Shivasa042/Potentiostat-Wearable-Sensor-Berkeley-MEng-Capstone/Originallibraries/HELPStat-main 4/HELPStat/Hardware/PCBWayQuotedBOM_5Sets_2024-01-11.xls

PCBWay Bom Quotation, Product No.:T-1Y23W557788A
Item # | *Designator | *Qty | Manufacturer | *Mfg Part # | Description / Value | Vendor Part # | *Package/Footprint | Mounting Type | Category | *Unit Price(5 sets) | *Total | *Delivery Time | *Actual Purchase Mfg Part #
1 | MCU | 1 | Espressif Systems | ESP32-S3-WROOM-1-N8R8 | Bluetooth, WiFi 802.11b/g/n, Bluetooth v5.0 Transceiver Module 2.4GHz PCB Trace Surface Mount | Digi-Key『 』1965-ESP32-S3-WROOM-1-N8R8CT-ND | 41-SMD Module | SMD | ESP32-S3-WROOM-1-N8R8 | $6.205 | $31.025 | 7-10 Workdays
2 | LDO | 1 | Diodes Incorporated | AP2112K-3.3TRG1 | Linear Voltage Regulator IC Positive Fixed 1 Output 600mA SOT-25 | Digi-Key『 』AP2112K-3.3TRG1DITR-ND | SOT-25 | SMD | 3.3V Regulator | $0.173 | $0.865
3 | USB | 1 | Amphenol FCI | 10118192-0001LF | USB - micro B USB 2.0 Receptacle Connector 5 Position Surface Mount, Right Angle | Digi-Key『 』609-4613-1-ND | Flange, Horizontal | SMD | Micro USB | $0.447 | $2.235
4 | Q1 | 1 | Diodes Incorporated | DMG2307LQ-7 | P-Channel 30 V 2.5A (Ta) 760mW (Ta) Surface Mount SOT-23-3 | Digi-Key『 』31-DMG2307LQ-7TR-ND | SOT-23-3 | SMD | PFET | $0.161 | $0.805
5 | D1 | 1 | STMicroelectronics | BAT20JFILM | DIODE SCHOTTKY 23V 1A SOD323 | Digi-Key『 』497-3381-2-ND | SOD-323 | SMD | Schottky Diode | $0.157 | $0.785
6 | RST, BOOT | 2 | C&K Components | PTS830GM140 SMTR LFS | Tactile Switch SPST-NO Top Actuated Surface Mount | Digi-Key『 』CKN10587CT-ND | Gull Wing | SMD | Tiny Rectangular Button | $0.925 | $9.250 | 7-10 Workdays
7 | IC1 | 1 | Microchip Technology | MCP73812T-420I/OT | IC BATT CNTL LI-ION 1CEL SOT23-5 | Digi-Key『 』MCP73812T-420I/OTTR-ND | SOT-23-5 | SMD | LiPo Charger / Monitor | $1.180 | $5.900
8 | PWR | 1 | Lite-On Inc. | LTST-C191KGKT | Green 571nm LED Indication - Discrete 2V 0603 (1608 Metric) | Digi-Key『 』160-1446-2-ND | 0603 | SMD | Green LED | $0.234 | $1.170
9 | CHRG | 1 | Lite-On Inc. | LTST-C190KSKT | Yellow 591nm LED Indication - Discrete 2.1V 0603 (1608 Metric) | Digi-Key『 』160-1437-2-ND | 0603 | SMD | Yellow LED | $0.107 | $0.535
10 | R4 | 1 | Panasonic Electronic Components | ERJ-2RKF1003X | 100 kOhms ±1% 0.1W, 1/10W Chip Resistor 0402 (1005 Metric) Automotive AEC-Q200 Thick Film | Digi-Key『 』P100KLTR-ND | 0402 | SMD | 100k Resistor | $0.079 | $0.395
11 | R6, R7, R8, R9, R10, R11, R12, R13 | 8 | Panasonic Electronic Components | ERJ-2GEJ473X | 47 kOhms ±5% 0.1W, 1/10W Chip Resistor 0402 (1005 Metric) Automotive AEC-Q200 Thick Film | Digi-Key『 』P47KJTR-ND | 0402 | SMD | 47k Resistor | $0.005 | $0.200
12 | R1 | 1 | Panasonic Electronic Components | ERJ-2RKF1002X | 10 kOhms ±1% 0.1W, 1/10W Chip Resistor 0402 (1005 Metric) Automotive AEC-Q200 Thick Film | Digi-Key『 』P10.0KLTR-ND | 0402 | SMD | 10k Resistor | $0.039 | $0.195
13 | R2, R3, R5 | 3 | Panasonic Electronic Components | ERJ-2RKF4701X | 4.7 kOhms ±1% 0.1W, 1/10W Chip Resistor 0402 (1005 Metric) Automotive AEC-Q200 Thick Film | Digi-Key『 』P4.70KLTR-ND | 0402 | SMD | 4.7k Resistor | $0.066 | $0.990
14 | C1, C2, C3, C4, C5, C6, C17 | 7 | Murata Electronics | GRM155R61A106ME11D | 10 µF ±20% 10V Ceramic Capacitor X5R 0402 (1005 Metric) | Digi-Key『 』490-GRM155R61A106ME11DTR-ND | 0402 | SMD | 10uF Capacitor | $0.049 | $1.715
15 | C11 | 1 | Samsung Electro-Mechanics | CL05A475MP5NRNC | 4.7 µF ±20% 10V Ceramic Capacitor X5R 0402 (1005 Metric) | Digi-Key『 』1276-1482-2-ND | 0402 | SMD | 4.7uF Capacitor | $0.108 | $0.540
16 | C7 | 1 | Murata Electronics | GRM155R61E105KA12D | 1 µF ±10% 25V Ceramic Capacitor X5R 0402 (1005 Metric) | Digi-Key『 』490-10017-2-ND | 0402 | SMD | 1uF Capacitor | $0.087 | $0.435
17 | C8, C9, C10, C12 | 4 | TDK Corporation | C1005X5R1E474K050BB | 0.47 µF ±10% 25V Ceramic Capacitor X5R 0402 (1005 Metric) | Digi-Key『 』445-8020-2-ND | 0402 | SMD | 0.47uF Capacitor | $0.095 | $1.900
18 | C13, C14, C15, C16, C18, C19 | 6 | Samsung Electro-Mechanics | CL05A104KA5NNNC | 0.1 µF ±10% 25V Ceramic Capacitor X5R 0402 (1005 Metric) | Digi-Key『 』1276-1043-2-ND | 0402 | SMD | 0.1uF Capacitor | $0.005 | $0.150
19 | AD5941 | 1 | Analog Devices Inc. | AD5941BCPZ-RL7 | BIO-IMPEDANCE & ELECTROCHEMICAL | Digi-Key『 』505-AD5941BCPZ-RL7TR-ND | 48-Lead LFSCP | SMD | AD5941 AFE | $12.508 | $62.540
20 | SDCARD | 1 | 3M | 2908-05WB-MG | 8 Position Card Connector Secure Digital - microSD™ Surface Mount, Right Angle Gold | Digi-Key『 』3M5607TR-ND | SMD, Right angle | SMD | MicroSD Card slot | $6.345 | $31.725 | 7-10 Workdays
 |  |  |  |  |  |  |  |  |  | Component Cost | $153.35
