Shivasa042/Potentiostat-Wearable-Sensor-Berkeley-MEng-Capstone/testing/sample_plots/bode.png

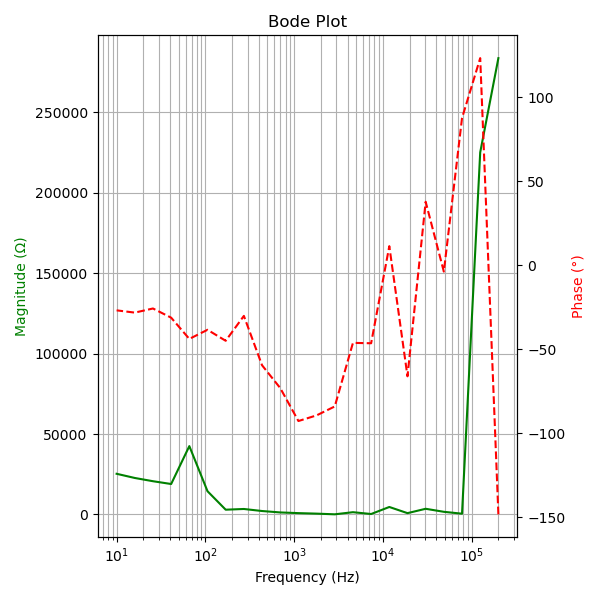
testing/sample_plots/bode.png
