Shivasa042/Potentiostat-Wearable-Sensor-Berkeley-MEng-Capstone/testing/sample_plots/dft_impedance_plots.png

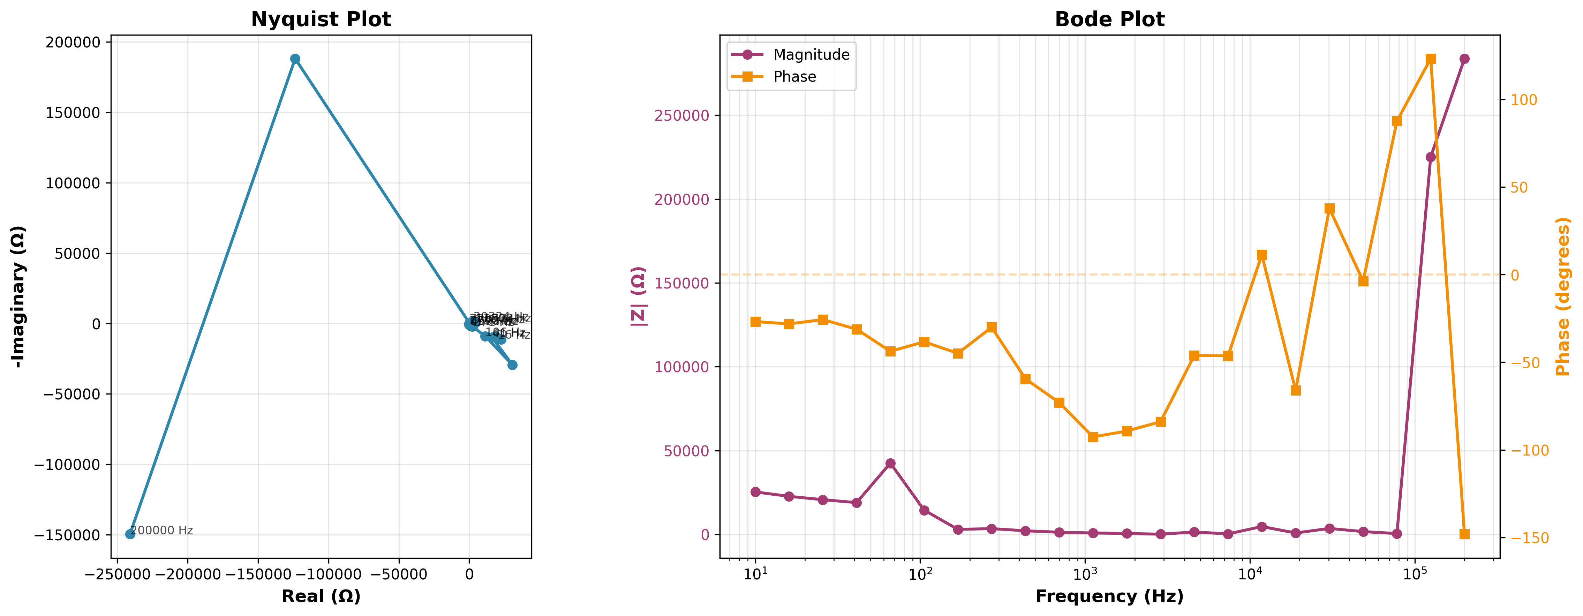
testing/sample_plots/dft_impedance_plots.png
