Shivasa042/Potentiostat-Wearable-Sensor-Berkeley-MEng-Capstone/testing/sample_plots/nyquist.png

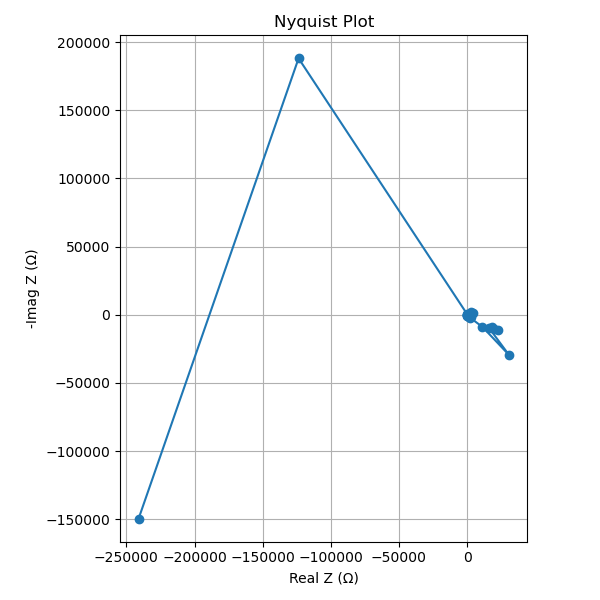
testing/sample_plots/nyquist.png
