Shivasa042/Potentiostat-Wearable-Sensor-Berkeley-MEng-Capstone/boards/New_EIS_PCB_Akshay/eis_pcb.kicad_pcb

## KiCad design boards/New_EIS_PCB_Akshay/eis_pcb.kicad_pcb (2026-04-08)

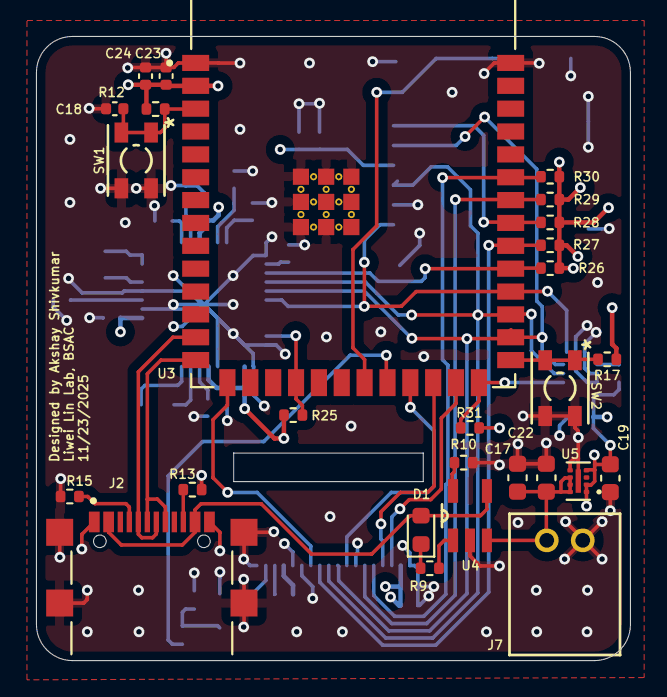
[picture p4: board eis_pcb.kicad_pcb from above]

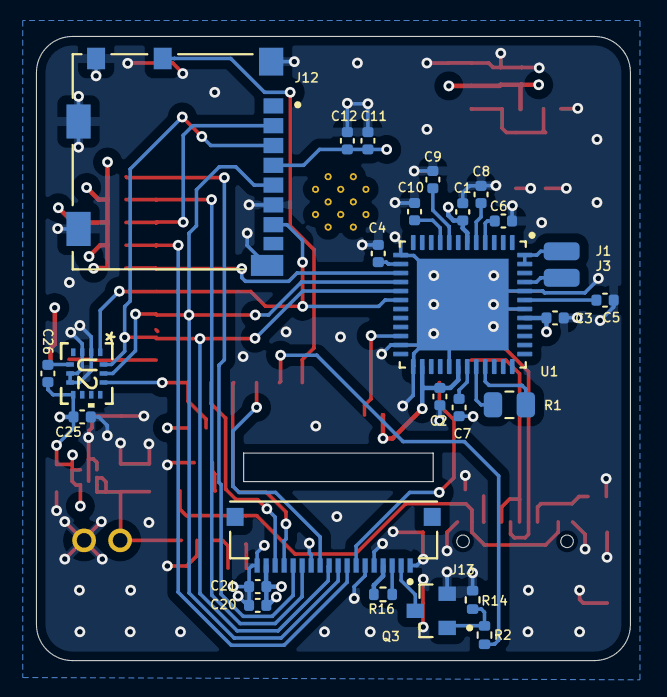
[picture p5: board eis_pcb.kicad_pcb from below]

Board: 4 copper layers, 33.0 x 34.7 mm, 54 parts (27 on the bottom side), 43 nets.

Parts:
C1, C2, C3, C9, C10: 100n; C_0402_1005Metric
C4, C6, C7, C8: 470n; C_0402_1005Metric
C5: 4.7u; C_0402_1005Metric
C11, C18: 10uF; C_0402_1005Metric
C12, C25, C26: 100nF; C_0402_1005Metric
C17: 10uF; C_0603_1608Metric
C19, C22: 1uF; C_0603_1608Metric
C20: 4.7uF; C_0402_1005Metric
C21: 0.1uF; C_0402_1005Metric
C23, C24: 1uF; C_0402_1005Metric
D1: LED; LED_0603_1608Metric
J1, J3: Conn_01x01_Socket; SolderWirePad_1x01_SMD_1x2mm
J2: GSB1C41110SSHR; AMPHENOL_GSB1C41110SSHR
J7: Conn_01x02_Socket; CONN_S2B-PH-K-S_JST
J12: 104031-0811; MOLEX_104031-0811
J13: 10051922-1810ELF; AMPHENOL_10051922-1810ELF
Q3: IRLML6344TRPBF; TRANS_IRLML6344TRPBF
R1: 10k; R_0805_2012Metric
R2: 100R; R_0402_1005Metric
R9, R10, R26, R27, R28, R29, R30, R31: 4.7k; R_0402_1005Metric
R12, R17, R25: 10k; R_0402_1005Metric
R13, R15: 5.1k; R_0402_1005Metric
R14: 100k; R_0402_1005Metric
R16: 10R; R_0402_1005Metric
SW1, SW2: SW_Push_Dual; SWITCH_0SMTRLFS-L
U1: AD5941BCPZ; QFN50P700X700X80-49N
U2: LGA14-L_2P59X3P1X0P5_STM; LGA14-L_2P59X3P1X0P5_STM-L
U3: ESP32-S3-WROOM-1-N8R8; XCVR_ESP32S3WROOM1N8R8
U4: MCP73831T-2DCI_OT; SOT95P270X145-5N
U5: NCP186AMX330TAG; PSON40P160X120X45-9N

Connections:
+3V3: C1.1, C2.1, C3.1, C11.1, C12.1, C19.1, C20.1, C21.1, C23.1, C24.1, C25.1, C26.1, J12.4 (VDD), J13.4, J13.17, R12.1, R16.1, R17.1, R25.2, R26.2, R27.2, R28.2, R29.2, R30.2, R31.2, U1.6 (DVDD), U1.26 (IOVDD), U1.30 (AVDD), U1.41 (AVDD), U3.2 (3V3), U5.1 (OUT), U5.2 (OUT__1), U5.4 (FB/ADJ)
+5V: D1.2 (A), J2.A4_B9 (VBUS_A), J2.B4_A9 (VBUS_B), U4.4 (VDD)
+BATT: C17.1, C22.1, J7.1, U4.3 (VBAT), U5.6 (EN), U5.7 (IN), U5.8 (IN__1)
/AFE.RST: R25.1, U1.22 (~RESET), U3.18 (IO10)
/AVDD.REG: C8.1, U1.5 (AVDD_REG)
/BIAS.0: C9.1, U1.8 (VBIAS0)
/BIAS.CAP: C7.1, U1.31 (VBIAS_CAP)
/BOOT: R17.2, SW2.1, SW2.2, U3.27 (IO0)
/CS.AFE: R26.1, U1.15 (~CS), U3.31 (IO38)
/CS.IMU: R31.1, U3.26 (IO45)
/CS.SCREEN: J13.8, R27.1, U3.32 (IO39)
/CS.SD: J12.2 (CD/DAT3), R28.1, U3.33 (IO40)
/CTP_INT: J13.16, U3.25 (IO48)
/CTP_RST: J13.15, U3.24 (IO47)
/CTP_SCL: J13.13, R29.1, U3.34 (IO41)
/CTP_SDA: J13.14, R30.1, U3.35 (IO42)
/DATA+: J2.A6 (DP1), J2.B6 (DP2), U3.14 (IO20)
/DATA-: J2.A7 (DN1), J2.B7 (DN2), U3.13 (IO19)
/DC: J13.7, U3.15 (IO3)
/DVDD.1V8: C4.1, U1.14 (DVDD_REG_1V8)
/ESP.PWM: R2.1, U3.22 (IO14)
/K: J13.2, Q3.3
/MCU.RST: C18.1, R12.2, SW1.1, SW1.2, U3.3 (EN)
/MISO: J12.7 (DAT0), U1.18 (MISO), U3.30 (IO37)
/MOSI: J12.3 (CMD), J13.10, U1.17 (MOSI), U3.28 (IO35)
/RE: J1.1, U1.47 (CE0), U1.48 (RE0)
/REF.1V8: C5.1, U1.43 (VREF_1V8)
/REF.2V5: C6.1, U1.4 (VREF_2V5)
/SCLK: J12.5 (CLK), J13.9, U1.16 (SCLK), U3.29 (IO36)
/SCREEN.RST: J13.11, U3.23 (IO21)
/SW1: J12.9 (SW-1), U3.21 (IO13)
/WE: J3.1, U1.45 (SE0)
/ZERO.0: C10.1, U1.9 (VZERO0)
GND: C1.2, C2.2, C3.2, C4.2, C5.2, C6.2, C7.2, C8.2, C9.2, C10.2, C11.2, C12.2, C17.2, C18.2, C19.2, C20.2, C21.2, C22.2, C23.2, C24.2, C25.2, J2.A1_B12 (GND_A), J2.B1_A12 (GND_B), J2.SH1 (SHIELD), J2.SH2 (SHIELD__1), J2.SH3 (SHIELD__2), J2.SH4 (SHIELD__3), J7.2, J12.6 (VSS), J12.10 (SW-2), J12.G1 (GND), J12.G2 (GND), J12.G3 (GND), J12.G4 (GND), J13.1, J13.5, J13.6, J13.12, J13.18, Q3.2, R10.1, R13.2, R14.2, R15.2, SW1.3, SW1.4, SW2.3, SW2.4, U1.13 (DGND), U1.23 (DGND), U1.25 (DGND), U1.29 (AGND), U1.42 (AGND), U1.44 (AGND_REF), U1.49 (EXP), U3.1 (GND), U3.40 (GND), U3.41_1 (GND), U3.41_2 (GND), U3.41_3 (GND), U3.41_4 (GND), U3.41_5 (GND), U3.41_6 (GND), U3.41_7 (GND), U3.41_8 (GND), U3.41_9 (GND), U4.2 (VSS), U5.5 (GND), U5.9 (EPAD)
unnamed: D1.1 (K), R9.1
unnamed: J2.A5 (CC1), R15.1
unnamed: J2.B5 (CC2), R13.1
unnamed: J13.3, R16.2
unnamed: Q3.1, R2.2, R14.1
unnamed: R1.1, U1.32 (RCAL0)
unnamed: R1.2, U1.33 (RCAL1)
unnamed: R10.2, U4.5 (PROG)
unnamed: R9.2, U4.1 (STAT)
