Shivasa042/Potentiostat-Wearable-Sensor-Berkeley-MEng-Capstone/Originallibraries/HELPStat-main 4/HELPStat/Hardware/HELPStat_V2.brd

## EAGLE design Originallibraries/HELPStat-main 4/HELPStat/Hardware/HELPStat_V2.brd (2026-03-20)

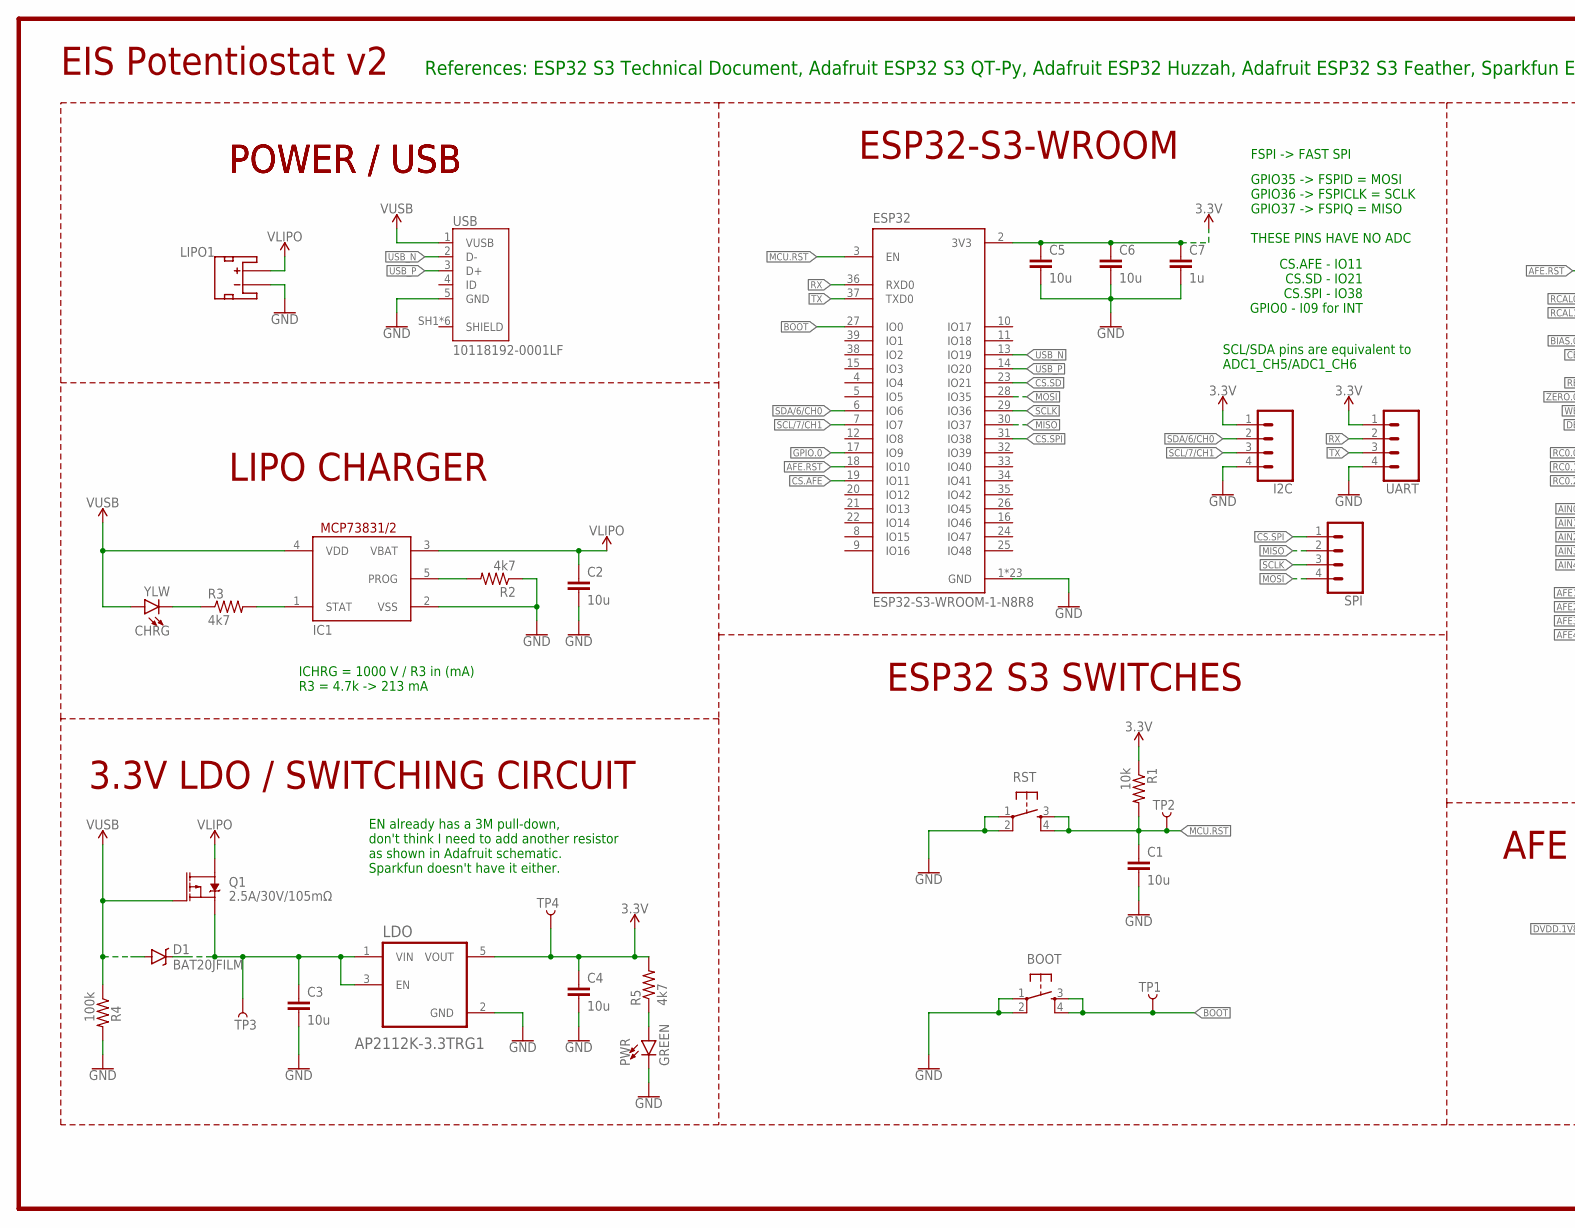
[picture p6: schematic HELPStat_V2.sch, part in row 1, column 1]

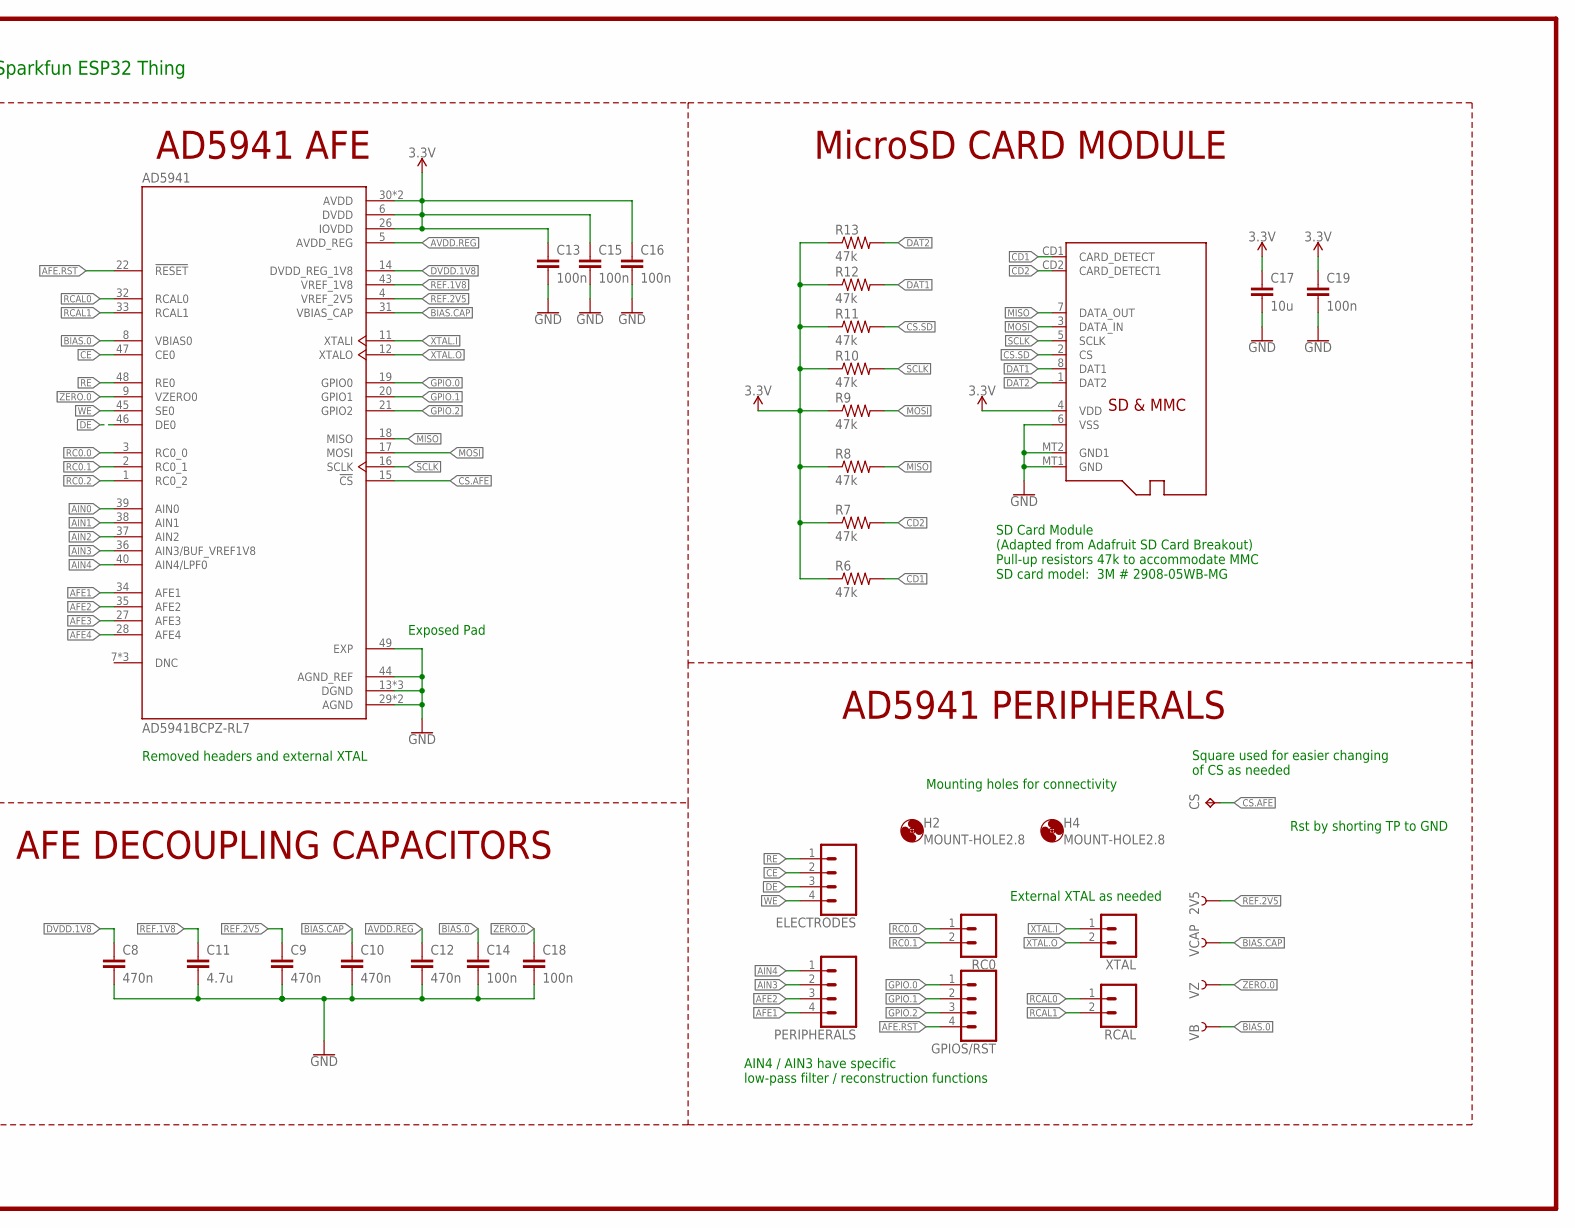
[picture p7: schematic HELPStat_V2.sch, part in row 1, column 2]

Parts:
2V5: TEST-POINT3X5; PAD.03X.05
AD5941: AD5941BCPZ-RL7; QFN50P700X700X80-49N
BOOT: SPST-PTS830GG140; BUTTON-GULLWING
C1, C2, C3, C4, C5, C6, C17: 10u; C0402
C7: 1u; C0402
C8, C9, C10, C12: 470n; C0402
C11: 4.7u; C0402
C13, C14, C15, C16, C18, C19: 100n; C0402
CHRG: YLW; LED-0603
CS: TPTP20SQ; TP20SQ
D1: BAT20JFILM; SOD-323
ELECTRODES: CONN_04; 1X04
ESP32: ESP32-S3-WROOM-1-N8R8; XCVR_ESP32S3WROOM1N8R8
GPIOS/RST: CONN_041.27MM; 1X04_1.27MM
H2, H4: MOUNT-HOLE2.8; 2,8
I2C: CONN_04; 1X04
IC1: MCP73831/OT; SOT23-5L
LDO: AP2112K-3.3TRG1; SOT95P285X140-5N
LIPO1: JST_2MM_MALE; JST-2-SMD
PERIPHERALS: CONN_041.27MM; 1X04_1.27MM
PWR: GREEN; LED-0603
Q1: 2.5A/30V/105mΩ; SOT23-3
R1: 10k; R0402
R2, R3, R5: 4k7; R0402
R4: 100k; R0603
R6, R7, R8, R9, R10, R11, R12, R13: 47k; R0402
RC0: CONN_02.50MIL; 1X02_1.27MM
RCAL: CONN_02; 1X02
RST: SPST-PTS830GG140; BUTTON-GULLWING
SDCARD: MICROSD
SPI: CONN_04; 1X04
TP1, TP2, TP3, TP4: TEST-POINT3X5; PAD.03X.05
UART: CONN_04; 1X04
USB: 10118192-0001LF; AMPHENOL_10118192-0001LF
VB: TEST-POINT3X5; PAD.03X.05
VCAP: TEST-POINT3X5; PAD.03X.05
VZ: TEST-POINT3X5; PAD.03X.05
XTAL: CONN_02.50MIL; 1X02_1.27MM

Connections:
3.3V: AD5941.6 (DVDD), AD5941.26 (IOVDD), AD5941.30 (AVDD), AD5941.41 (AVDD), C4.1, C5.1, C6.1, C7.1, C13.1, C15.1, C16.1, C17.1, C19.1, ESP32.2 (3V3), I2C.1, LDO.5 (VOUT), R1.1, R5.2, R6.1, R7.1, R8.1, R9.1, R10.1, R11.1, R12.1, R13.1, SDCARD.4 (VDD), TP4.P$1, UART.1
AFE1: AD5941.34 (AFE1), PERIPHERALS.4
AFE2: AD5941.35 (AFE2), PERIPHERALS.3
AFE3: AD5941.27 (AFE3)
AFE4: AD5941.28 (AFE4)
AFE.RST: AD5941.22 (!RESET), ESP32.18 (IO10), GPIOS/RST.4
AIN0: AD5941.39 (AIN0)
AIN1: AD5941.38 (AIN1)
AIN2: AD5941.37 (AIN2)
AIN3: AD5941.36 (AIN3/BUF_VREF1V8), PERIPHERALS.2
AIN4: AD5941.40 (AIN4/LPF0), PERIPHERALS.1
AVDD.REG: AD5941.5 (AVDD_REG), C12.1
BIAS.0: AD5941.8 (VBIAS0), C14.1, VB.P$1
BIAS.CAP: AD5941.31 (VBIAS_CAP), C10.1, VCAP.P$1
BOOT: BOOT.3, BOOT.4, ESP32.27 (IO0), TP1.P$1
CD1: R6.2, SDCARD.CD1 (CARD_DETECT)
CD2: R7.2, SDCARD.CD2 (CARD_DETECT1)
CE: AD5941.47 (CE0), ELECTRODES.2
CS.AFE: AD5941.15 (!CS), CS.TP, ESP32.19 (IO11)
CS.SD: ESP32.23 (IO21), R11.2, SDCARD.2 (CS)
CS.SPI: ESP32.31 (IO38), SPI.1
DAT1: R12.2, SDCARD.8 (DAT1)
DAT2: R13.2, SDCARD.1 (DAT2)
DE: AD5941.46 (DE0), ELECTRODES.3
DVDD.1V8: AD5941.14 (DVDD_REG_1V8), C8.1
GND: AD5941.13 (DGND), AD5941.23 (DGND), AD5941.25 (DGND), AD5941.29 (AGND), AD5941.42 (AGND), AD5941.44 (AGND_REF), AD5941.49 (EXP), BOOT.1, BOOT.2, C1.2, C2.2, C3.2, C4.2, C5.2, C6.2, C7.2, C8.2, C9.2, C10.2, C11.2, C12.2, C13.2, C14.2, C15.2, C16.2, C17.2, C18.2, C19.2, ESP32.1 (GND), ESP32.40 (GND), ESP32.41_1 (GND), ESP32.41_2 (GND), ESP32.41_3 (GND), ESP32.41_4 (GND), ESP32.41_5 (GND), ESP32.41_6 (GND), ESP32.41_7 (GND), ESP32.41_8 (GND), ESP32.41_9 (GND), ESP32.41_10 (GND), ESP32.41_11 (GND), ESP32.41_12 (GND), ESP32.41_13 (GND), ESP32.41_14 (GND), ESP32.41_15 (GND), ESP32.41_16 (GND), ESP32.41_17 (GND), ESP32.41_18 (GND), ESP32.41_19 (GND), ESP32.41_20 (GND), ESP32.41_21 (GND), I2C.4, IC1.2 (VSS), LDO.2 (GND), LIPO1.1 (-), PWR.C, R2.1, R4.2, RST.1, RST.2, SDCARD.6 (VSS), SDCARD.MT1 (GND), SDCARD.MT2 (GND1), UART.4, USB.5 (GND)
GPIO.0: AD5941.19 (GPIO0), ESP32.17 (IO9), GPIOS/RST.1
GPIO.1: AD5941.20 (GPIO1), GPIOS/RST.2
GPIO.2: AD5941.21 (GPIO2), GPIOS/RST.3
MCU.RST: C1.1, ESP32.3 (EN), R1.2, RST.3, RST.4, TP2.P$1
MISO: AD5941.18 (MISO), ESP32.30 (IO37), R8.2, SDCARD.7 (DATA_OUT), SPI.2
MOSI: AD5941.17 (MOSI), ESP32.28 (IO35), R9.2, SDCARD.3 (DATA_IN), SPI.4
unnamed: CHRG.C, R3.1
unnamed: IC1.1 (STAT), R3.2
unnamed: IC1.5 (PROG), R2.2
unnamed: PWR.A, R5.1
unnamed: C3.1, D1.C, LDO.1 (VIN), LDO.3 (EN), Q1.2 (S), TP3.P$1
RC0.0: AD5941.3 (RC0_0), RC0.1
RC0.1: AD5941.2 (RC0_1), RC0.2
RC0.2: AD5941.1 (RC0_2)
RCAL0: AD5941.32 (RCAL0), RCAL.1
RCAL1: AD5941.33 (RCAL1), RCAL.2
RE: AD5941.48 (RE0), ELECTRODES.1
REF.1V8: AD5941.43 (VREF_1V8), C11.1
REF.2V5: 2V5.P$1, AD5941.4 (VREF_2V5), C9.1
RX: ESP32.36 (RXD0), UART.2
SCL/7/CH1: ESP32.7 (IO7), I2C.3
SCLK: AD5941.16 (SCLK), ESP32.29 (IO36), R10.2, SDCARD.5 (SCLK), SPI.3
SDA/6/CH0: ESP32.6 (IO6), I2C.2
TX: ESP32.37 (TXD0), UART.3
USB_N: ESP32.13 (IO19), USB.2 (D-)
USB_P: ESP32.14 (IO20), USB.3 (D+)
VLIPO: C2.1, IC1.3 (VBAT), LIPO1.2 (+), Q1.3 (D)
V_USB: CHRG.A, D1.A, IC1.4 (VDD), Q1.1 (G), R4.1, USB.1 (VUSB)
WE: AD5941.45 (SE0), ELECTRODES.4
XTAL.I: AD5941.11 (XTALI), XTAL.1
XTAL.O: AD5941.12 (XTALO), XTAL.2
ZERO.0: AD5941.9 (VZERO0), C18.1, VZ.P$1

Notes on the sheet:
ICHRG = 1000 V / R3 in (mA) R3 = 4.7k -> 213 mA
POWER / USB
LIPO CHARGER
3.3V LDO / SWITCHING CIRCUIT
ESP32 S3 SWITCHES
EIS Potentiostat v2
SCL/SDA pins are equivalent to ADC1_CH5/ADC1_CH6
References: ESP32 S3 Technical Document, Adafruit ESP32 S3 QT-Py, Adafruit ESP32 Huzzah, Adafruit ESP32 S3 Feather, Sparkfun ESP32 Thing
EN already has a 3M pull-down, don't think I need to add another resistor as shown in Adafruit schematic. Sparkfun doesn't have it either.
GPIO35 -> FSPID = MOSI GPIO36 -> FSPICLK = SCLK GPIO37 -> FSPIQ = MISO THESE PINS HAVE NO ADC
FSPI -> FAST SPI
ESP32-S3-WROOM
Exposed Pad
AFE DECOUPLING CAPACITORS
AD5941 AFE
Removed headers and external XTAL
CS.AFE - IO11 CS.SD - IO21 CS.SPI - IO38 GPIO0 - I09 for INT
SD Card Module (Adapted from Adafruit SD Card Breakout) Pull-up resistors 47k to accommodate MMC SD card model: 3M # 2908-05WB-MG
MicroSD CARD MODULE
AD5941 PERIPHERALS
Rst by shorting TP to GND
Square used for easier changing of CS as needed
AIN4 / AIN3 have specific low-pass filter / reconstruction functions
External XTAL as needed
Mounting holes for connectivity

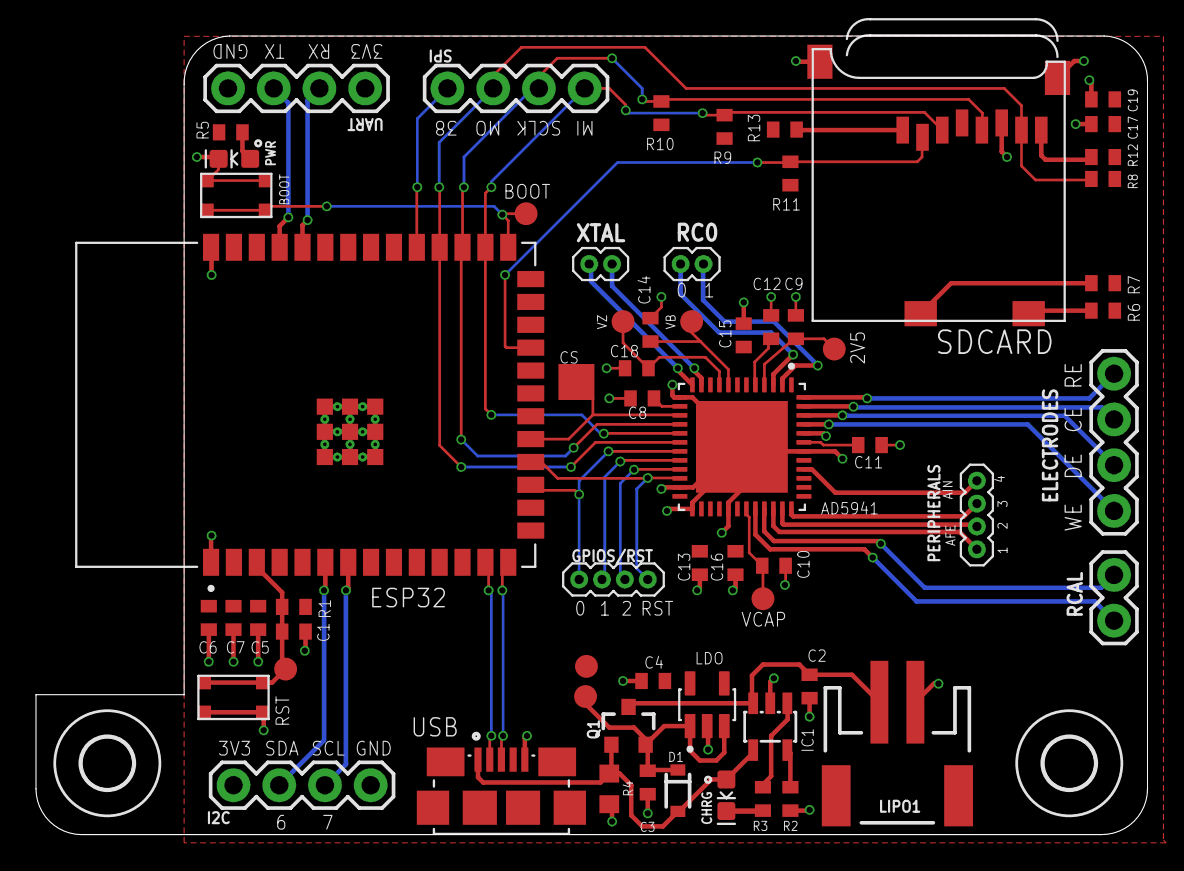
[picture p8: board HELPStat_V2.brd from above]

Board: 2 copper layers, 61.8 x 44.4 mm, 65 parts (0 on the bottom side), 52 nets.
