Shivasa042/Potentiostat-Wearable-Sensor-Berkeley-MEng-Capstone/src/main.cpp

/*
    AUTHORS: Kevin Alessandro Bautista, Shannon Riegle
    EMAIL: kbautis@purdue.edu, sdriegle@iu.edu

    DISCLAIMER: 
    Linnes Lab code, firmware, and software is released under the MIT License
    (http://opensource.org/licenses/MIT).
    
    The MIT License (MIT)
    
    Copyright (c) 2024 Linnes Lab, Purdue University, West Lafayette, IN, USA
    
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
    THE SOFTWARE IS PROVIDED "AS IS", WITHOUT WARRANTY OF ANY KIND, EXPRESS OR
    IMPLIED, INCLUDING BUT NOT LIMITED TO THE WARRANTIES OF MERCHANTABILITY,
    FITNESS FOR A PARTICULAR PURPOSE AND NONINFRINGEMENT. IN NO EVENT SHALL THE
    AUTHORS OR COPYRIGHT HOLDERS BE LIABLE FOR ANY CLAIM, DAMAGES OR OTHER
    LIABILITY, WHETHER IN AN ACTION OF CONTRACT, TORT OR OTHERWISE, ARISING FROM,
    OUT OF OR IN CONNECTION WITH THE SOFTWARE OR THE USE OR OTHER DEALINGS IN THE
    SOFTWARE.
*/

#include <Arduino.h>
#include <Preferences.h>
#include "HELPStat.h"
#ifdef BOARD_EIS_PCB_AKSHAY
#include "eis_board_ui.h"
#endif
#include <vector>
#include <string>
#include "esp_task_wdt.h"
#include "esp_sleep.h"

static Preferences g_calPrefs;

static void loadRcalFromNVS(float& rcalOut, HELPStat& demo) {
  g_calPrefs.begin("helpstat", true);
  float stored = g_calPrefs.getFloat("rcal", NAN);
  g_calPrefs.end();
  if (!isnan(stored) && stored > 0.5f && stored < 1.0e6f) {
    rcalOut = stored;
    demo.setRcalVal(stored);
    Serial.print("Loaded RCAL from NVS: ");
    Serial.print(stored, 4);
    Serial.println(" Ohm");
  }
}

// Forward declaration for MeasurementMode enum (defined in HELPStat.h)
// The enum is already included via HELPStat.h

/* Reference constants for gain values - taken from AD5941.h library by Analog Devices */
//#define HSTIARTIA_200               0     /**< HSTIA Internal RTIA resistor 200  */
//#define HSTIARTIA_1K                1     /**< HSTIA Internal RTIA resistor 1K   */
//#define HSTIARTIA_5K                2     /**< HSTIA Internal RTIA resistor 5K   */
//#define HSTIARTIA_10K               3     /**< HSTIA Internal RTIA resistor 10K  */
//#define HSTIARTIA_20K               4     /**< HSTIA Internal RTIA resistor 20K  */
//#define HSTIARTIA_40K               5     /**< HSTIA Internal RTIA resistor 40K  */
//#define HSTIARTIA_80K               6     /**< HSTIA Internal RTIA resistor 80K  */
//#define HSTIARTIA_160K              7     /**< HSTIA Internal RTIA resistor 160K */
//#define HSTIARTIA_OPEN              8     /**< Open internal resistor */

//#define EXCITBUFGAIN_2              0   /**< Excitation buffer gain is x2 */
//#define EXCITBUFGAIN_0P25           1   /**< Excitation buffer gain is x1/4 */

//#define HSDACGAIN_1                 0   /**< Gain is x1 */
//#define HSDACGAIN_0P2               1   /**< Gain is x1/5 */

/* Button / LED: HELPStat V2 (IO7/IO6). New EIS PCB: SW1 on IO13; no dedicated LED (use display). */
#undef BUTTON
#undef LEDPIN
#if defined(BOARD_EIS_PCB_AKSHAY)
#define BUTTON 13
#define LEDPIN (-1)
#else
#define BUTTON 7
#define LEDPIN 6
#endif

// Forward declaration
void blinkLED(int cycles, bool state);

/* Frequency-keyed RTIA schedule (WatchScript-style). Last threshold must be >= max sweep frequency (200 kHz here). */
calHSTIA test[] = {
  {0.51f,   HSTIARTIA_40K},
  {1.5f,    HSTIARTIA_10K},
  {20.0f,   HSTIARTIA_5K},
  {150.0f,  HSTIARTIA_5K},
  {400.0f,  HSTIARTIA_1K},
  {200000.0f, HSTIARTIA_200},
};
 
/* Variables for function inputs */
int gainSize = (int)sizeof(test) / sizeof(test[0]);

uint32_t numCycles = 0; 
uint32_t delaySecs = 0; 
uint32_t numPoints = 1; 

float startFreq = 200000; 
float endFreq = 1;
float biasVolt = 0.0; 
float zeroVolt = 0.0; 
float rcalVal = 10000.0f; // Match populated RCAL (10 kΩ); DMM + RCAL: / NVS.

int extGain = 1; 
int dacGain = 1; 

float rct_estimate = 127000;
float rs_estimate = 150;

HELPStat demo;

/* Initializing Analog Pins and Potentiostat pins */
// SD-card output location for EIS sweeps.
// saveDataEIS() writes to: /<folderName>/<fileName>.csv
String folderName = "eis";
String fileName = "sweep_1Hz_200kHz";

// Serial command parsing
String serialInput = "";
bool measurementRequested = false;

// Wearable / standalone auto-sweep settings
// USB / bench: false avoids a minutes-long auto-sweep before serial commands are useful. Enable for Scenario 3 (WEARABLE:ON).
bool wearableMode = false;
unsigned long sweepIntervalSec = 300;   // seconds between auto-sweeps (default 5 min)
unsigned long lastSweepMs = 0;
bool firstBoot = true;

void parseSerialCommand() {
  if (Serial.available() > 0) {
    String command = Serial.readStringUntil('\n');
    command.trim();
    command.toUpperCase();
    
    if (command.length() == 0) return;
    
    // HELP command
    if (command == "HELP" || command == "?") {
      Serial.println("\n=== HELPStat Serial Commands ===");
      Serial.println("MEASURE - Start measurement with current/default parameters");
      Serial.println("MEASURE:mode,startFreq,endFreq,numPoints,biasVolt,zeroVolt,rcalVal,extGain,dacGain,rct_est,rs_est,numCycles,delaySecs,amplitude");
      Serial.println("SET:mode,startFreq,endFreq,numPoints,biasVolt,zeroVolt,rcalVal,extGain,dacGain,rct_est,rs_est,numCycles,delaySecs,amplitude");
      Serial.println("MEASURE:SAMPLE or MEASURE:DEFAULT - run built-in 1Hz-200kHz EIS sweep");
      Serial.println("STOP - abort a running sweep (also works mid-sweep via BLE start=2)");
      Serial.println("\nWearable / Standalone:");
      Serial.println("  WEARABLE:ON  - enable auto-sweep timer (Scenario 3 / field)");
      Serial.println("  WEARABLE:OFF - disable auto-sweep, manual only");
      Serial.println("  INTERVAL:N   - set auto-sweep interval to N seconds (default 300)");
      Serial.println("\nMeasurement Modes:");
      Serial.println("  0 = EIS (Electrochemical Impedance Spectroscopy)");
      Serial.println("  1 = CV (Cyclic Voltammetry)");
      Serial.println("  2 = IT/CA (Chronoamperometry)");
      Serial.println("  3 = CP (Chronopotentiometry)");
      Serial.println("  4 = DPV (Differential Pulse Voltammetry)");
      Serial.println("  5 = SWV (Square Wave Voltammetry)");
      Serial.println("  6 = OCP (Open Circuit Potential)");
      Serial.println("\nParameters:");
      Serial.println("  mode: Measurement mode (0-6)");
      Serial.println("  startFreq: Start frequency (Hz) - for EIS only");
      Serial.println("  endFreq: End frequency (Hz) - for EIS only");
      Serial.println("  numPoints: Number of points per decade (EIS) or total points");
      Serial.println("  biasVolt: Bias voltage (V)");
      Serial.println("  zeroVolt: Zero voltage (V)");
      Serial.println("  rcalVal: Calibration resistor value (Ohms)");
      Serial.println("  extGain: External gain (1 or 2)");
      Serial.println("  dacGain: DAC gain (1 or 0.2)");
      Serial.println("  rct_est: Estimated Rct (Ohms)");
      Serial.println("  rs_est: Estimated Rs (Ohms)");
      Serial.println("  numCycles: Number of measurement cycles");
      Serial.println("  delaySecs: Delay between cycles (seconds)");
      Serial.println("  amplitude: Signal amplitude (mV, 0-800)");
      Serial.println("\nExamples:");
      Serial.println("  EIS: MEASURE:0,200000,1,10,0,0,10000,1,1,127000,150,0,0,200");
      Serial.println("  CV:  MEASURE:1,0,0,100,0.0,1.0,1000,1,1,0,0,1,0,50");
      Serial.println("SHOW - Display current settings");
      Serial.println("STATUS - Show measurement status");
      Serial.println("RCAL:ohms - Set RCAL & save to NVS (e.g. RCAL:98.7); RCAL:SHOW - print NVS/runtime");
#if defined(BOARD_EIS_PCB_AKSHAY)
      Serial.println("DISPLAYRANGE:min,max,value[,title] - show value in range on SPI display");
#endif
      Serial.println("HELP - Show this help message");
      Serial.println("================================\n");
      return;
    }
    
    // STOP command — abort a running sweep
    if (command == "STOP") {
      demo.requestAbort();
      Serial.println("STOP received — sweep abort requested.");
      return;
    }

    // STATUS command
    if (command == "STATUS") {
      Serial.println("\n=== STATUS ===");
      Serial.print("Measurement Requested: ");
      Serial.println(measurementRequested ? "YES" : "NO");
      Serial.print("Wearable auto-sweep: ");
      Serial.println(wearableMode ? "ON" : "OFF");
      Serial.print("Sweep interval: ");
      Serial.print(sweepIntervalSec);
      Serial.println(" s");
      unsigned long elapsed = (millis() - lastSweepMs) / 1000;
      Serial.print("Time since last sweep: ");
      Serial.print(elapsed);
      Serial.println(" s");
      Serial.println("================\n");
      return;
    }

    // WEARABLE:ON / WEARABLE:OFF
    if (command.startsWith("WEARABLE:")) {
      String val = command.substring(9);
      if (val == "ON") {
        wearableMode = true;
        lastSweepMs = millis();
        Serial.println("Wearable auto-sweep ENABLED");
      } else if (val == "OFF") {
        wearableMode = false;
        Serial.println("Wearable auto-sweep DISABLED (manual only)");
      } else {
        Serial.println("Usage: WEARABLE:ON or WEARABLE:OFF");
      }
      return;
    }

    // INTERVAL:N  (seconds)
    if (command.startsWith("INTERVAL:")) {
      unsigned long sec = command.substring(9).toInt();
      if (sec >= 10) {
        sweepIntervalSec = sec;
        Serial.print("Auto-sweep interval set to ");
        Serial.print(sec);
        Serial.println(" seconds");
      } else {
        Serial.println("Minimum interval is 10 seconds.");
      }
      return;
    }

    // CHECK command - verify AD5940 connectivity manually
    if (command == "CHECK") {
      uint32_t chipid = AD5940_ReadReg(REG_AFECON_CHIPID);
      Serial.print("AD5940 CHIPID read: 0x");
      Serial.println(chipid, HEX);
      if(chipid == 0x0000 || chipid == 0xFFFF) {
        Serial.println("-> WARNING: AD5940 not responding");
      } else {
        Serial.println("-> AD5940 appears connected");
      }
      return;
    }
    
    // SHOW command
    if (command == "SHOW") {
      demo.print_settings();
      return;
    }

#if defined(BOARD_EIS_PCB_AKSHAY)
    if (command.startsWith("DISPLAYRANGE:")) {
      String rest = command.substring(13);
      rest.trim();
      float v0 = NAN, v1 = NAN, v2 = NAN;
      int c0 = rest.indexOf(',');
      int c1 = rest.indexOf(',', c0 + 1);
      int c2 = rest.indexOf(',', c1 + 1);
      if (c0 > 0 && c1 > c0) {
        v0 = rest.substring(0, c0).toFloat();
        v1 = rest.substring(c0 + 1, c1).toFloat();
        if (c2 > c1) {
          v2 = rest.substring(c1 + 1, c2).toFloat();
        } else {
          v2 = rest.substring(c1 + 1).toFloat();
        }
      }
      const char *title = "Range";
      if (c2 > c1) {
        String t = rest.substring(c2 + 1);
        t.trim();
        static char titleBuf[48];
        t.toCharArray(titleBuf, sizeof(titleBuf));
        title = titleBuf;
      }
      if (isnan(v0) || isnan(v1) || isnan(v2)) {
        Serial.println("Usage: DISPLAYRANGE:min,max,value  or  DISPLAYRANGE:min,max,value,title");
      } else {
        eis_board_ui_show_numeric_range(v0, v1, v2, title);
        Serial.println("DISPLAYRANGE updated.");
      }
      return;
    }
#endif

    // RCAL:ohms — set calibration resistor value, persist to NVS (survives reboot)
    if (command.startsWith("RCAL:")) {
      String rest = command.substring(5);
      rest.trim();
      if (rest == "SHOW" || rest == "?") {
        g_calPrefs.begin("helpstat", true);
        float s = g_calPrefs.getFloat("rcal", NAN);
        g_calPrefs.end();
        Serial.print("NVS RCAL (Ohm): ");
        if (isnan(s)) {
          Serial.println("(not set)");
        } else {
          Serial.println(s, 4);
        }
        Serial.print("Runtime rcalVal (Ohm): ");
        Serial.println(rcalVal, 4);
        return;
      }
      float v = rest.toFloat();
      if (v > 0.5f && v < 1.0e6f) {
        rcalVal = v;
        demo.setRcalVal(v);
        g_calPrefs.begin("helpstat", false);
        g_calPrefs.putFloat("rcal", v);
        g_calPrefs.end();
        Serial.print("RCAL set to ");
        Serial.print(v, 4);
        Serial.println(" Ohm and saved to NVS.");
      } else {
        Serial.println("Invalid RCAL. Example: RCAL:98.7  |  RCAL:SHOW");
      }
      return;
    }
    
    // MEASURE:SAMPLE must run before startsWith("MEASURE") or it is parsed as invalid params.
    if (command == "MEASURE:SAMPLE" || command == "MEASURE:DEFAULT") {
      demo.setParameters(
        MODE_EIS,          // EIS mode
        200000.0,          // start frequency 200 kHz
        1.0,               // end frequency 1 Hz
        5,                 // points per decade
        0.0,               // bias
        0.0,               // zero volt
        rcalVal,           // rcal (DMM / RCAL: / NVS)
        1,                 // extGain
        1,                 // dacGain
        rct_estimate,      // rct_est
        rs_estimate,       // rs_est
        0,                 // numCycles
        0,                 // delaySecs
        200.0              // amplitude mV
      );
      measurementRequested = true;
      Serial.println("Default/sample EIS sweep requested (1Hz-200kHz)");
      return;
    }

    // MEASURE command (full parameter list)
    if (command.startsWith("MEASURE")) {
      if (command.length() > 8) {
        // Parse parameters from command
        String params = command.substring(8); // Skip "MEASURE:"
        int paramCount = 0;
        float paramsArray[14];  // Increased to 14 for mode + amplitude
        
        // Parse comma-separated values
        int startIdx = 0;
        for (int i = 0; i <= params.length(); i++) {
          if (i == params.length() || params.charAt(i) == ',') {
            if (paramCount < 14) {
              paramsArray[paramCount] = params.substring(startIdx, i).toFloat();
              paramCount++;
            }
            startIdx = i + 1;
          }
        }
        
        // Support both old format (12 params) and new format (14 params)
        if (paramCount == 12) {
          // Legacy format - default to EIS mode with 200mV amplitude
          demo.setParameters(
            MODE_EIS,           // mode (default EIS)
            paramsArray[0],      // startFreq
            paramsArray[1],      // endFreq
            (uint32_t)paramsArray[2],  // numPoints
            paramsArray[3],     // biasVolt
            paramsArray[4],     // zeroVolt
            paramsArray[5],     // rcalVal
            (int)paramsArray[6],  // extGain
            (int)paramsArray[7],  // dacGain
            paramsArray[8],     // rct_estimate
            paramsArray[9],     // rs_estimate
            (uint32_t)paramsArray[10], // numCycles
            (uint32_t)paramsArray[11], // delaySecs
            200.0                // amplitude (default 200mV)
          );
          rcalVal = paramsArray[5];
          rct_estimate = paramsArray[8];
          rs_estimate = paramsArray[9];
          Serial.println("Parameters set from command (legacy format, defaulting to EIS mode).");
        } else if (paramCount == 14) {
          // New format with mode and amplitude
          demo.setParameters(
            (int)paramsArray[0],  // mode
            paramsArray[1],       // startFreq
            paramsArray[2],       // endFreq
            (uint32_t)paramsArray[3],  // numPoints
            paramsArray[4],      // biasVolt
            paramsArray[5],      // zeroVolt
            paramsArray[6],      // rcalVal
            (int)paramsArray[7],  // extGain
            (int)paramsArray[8],  // dacGain
            paramsArray[9],      // rct_estimate
            paramsArray[10],      // rs_estimate
            (uint32_t)paramsArray[11], // numCycles
            (uint32_t)paramsArray[12], // delaySecs
            paramsArray[13]      // amplitude
          );
          rcalVal = paramsArray[6];
          rct_estimate = paramsArray[9];
          rs_estimate = paramsArray[10];
          Serial.println("Parameters set from command.");
        } else {
          Serial.println("ERROR: Invalid parameter count. Expected 12 (legacy) or 14 (new format) parameters.");
          Serial.println("New format: MEASURE:mode,startFreq,endFreq,numPoints,biasVolt,zeroVolt,rcalVal,extGain,dacGain,rct_est,rs_est,numCycles,delaySecs,amplitude");
          return;
        }
      }
      // Trigger measurement
      measurementRequested = true;
      Serial.println("Measurement requested. Starting...");
      return;
    }

    // SET command (set parameters without measuring)
    if (command.startsWith("SET:")) {
      String params = command.substring(4); // Skip "SET:"
      int paramCount = 0;
      float paramsArray[14];  // Increased to 14 for mode + amplitude
      
      int startIdx = 0;
      for (int i = 0; i <= params.length(); i++) {
        if (i == params.length() || params.charAt(i) == ',') {
          if (paramCount < 14) {
            paramsArray[paramCount] = params.substring(startIdx, i).toFloat();
            paramCount++;
          }
          startIdx = i + 1;
        }
      }
      
      // Support both old format (12 params) and new format (14 params)
      if (paramCount == 12) {
        // Legacy format - default to EIS mode with 200mV amplitude
        demo.setParameters(
          MODE_EIS,           // mode (default EIS)
          paramsArray[0],     // startFreq
          paramsArray[1],     // endFreq
          (uint32_t)paramsArray[2],  // numPoints
          paramsArray[3],     // biasVolt
          paramsArray[4],     // zeroVolt
          paramsArray[5],     // rcalVal
          (int)paramsArray[6],  // extGain
          (int)paramsArray[7],  // dacGain
          paramsArray[8],     // rct_estimate
          paramsArray[9],     // rs_estimate
          (uint32_t)paramsArray[10], // numCycles
          (uint32_t)paramsArray[11], // delaySecs
          200.0                // amplitude (default 200mV)
        );
        rcalVal = paramsArray[5];
        rct_estimate = paramsArray[8];
        rs_estimate = paramsArray[9];
        Serial.println("Parameters updated successfully (legacy format, defaulting to EIS mode).");
        demo.print_settings();
      } else if (paramCount == 14) {
        // New format with mode and amplitude
        demo.setParameters(
          (int)paramsArray[0],  // mode
          paramsArray[1],      // startFreq
          paramsArray[2],      // endFreq
          (uint32_t)paramsArray[3],  // numPoints
          paramsArray[4],      // biasVolt
          paramsArray[5],      // zeroVolt
          paramsArray[6],      // rcalVal
          (int)paramsArray[7],  // extGain
          (int)paramsArray[8],  // dacGain
          paramsArray[9],      // rct_estimate
          paramsArray[10],      // rs_estimate
          (uint32_t)paramsArray[11], // numCycles
          (uint32_t)paramsArray[12], // delaySecs
          paramsArray[13]      // amplitude
        );
        rcalVal = paramsArray[6];
        rct_estimate = paramsArray[9];
        rs_estimate = paramsArray[10];
        Serial.println("Parameters updated successfully.");
        demo.print_settings();
      } else {
        Serial.println("ERROR: Invalid parameter count. Expected 12 (legacy) or 14 (new format) parameters.");
      }
      return;
    }
    
    // Unknown command
    Serial.print("Unknown command: ");
    Serial.println(command);
    Serial.println("Type HELP for available commands.");
  }
}

void setup() {
  esp_task_wdt_deinit();

  Serial.begin(115200);
  delay(1000);
  
  Serial.println("\n=== HELPStat EIS Measurement System ===");
  Serial.println("Mode: 2-electrode (auto-sweep OFF by default; WEARABLE:ON for Scenario 3)");
  Serial.println("Type HELP for commands, WEARABLE:ON to enable timed sweeps");
  Serial.println("=======================================\n");
  
  demo.BLE_setup();

#if LEDPIN >= 0
  pinMode(LEDPIN, OUTPUT);
  digitalWrite(LEDPIN, HIGH);
#endif
  pinMode(BUTTON, INPUT_PULLUP);

  demo.AD5940Start();

#ifdef BOARD_EIS_PCB_AKSHAY
  eis_board_ui_init();
#endif

  {
    uint32_t chipid = AD5940_ReadReg(REG_AFECON_CHIPID);
    Serial.print("AD5940 connection check, CHIPID=0x");
    Serial.println(chipid, HEX);
    if(chipid == 0x0000 || chipid == 0xFFFF) {
      Serial.println("WARNING: AD5940 may not be connected or responding!");
    }
  }

  loadRcalFromNVS(rcalVal, demo);
  demo.setDataLogNames(folderName, fileName);

  Serial.println("System ready! Type HELP for commands or MEASURE to start.");

  /* Main Testing Code - run these functions if you want to run without the loop */
//  demo.AD5940_TDD(100000, 0.1, 6, 0.0, 0.0, 9870, test, gainSize, 1, 1);
//  Serial.print("Calibration size: ");
//  Serial.println(gainSize);
  
  /* Testing Sweep - needs AD5940_TDD to be uncommented too */
//  demo.runSweep(0, 0);

  /* Testing SD card */
//  demo.printData(); `
//  demo.saveDataEIS("EIS data", "03-02-24-pc-ph-e2-5mM-kfecn-pbs-1Mtie");

  /* 
   *  Running Analog Devices Code for Impedance - adapted to use the gain array. 
   *  Note: this runs indefinitely. Comment out all the other demo functions 
   *  exceot AD5940_Start before running this. 
  */
  
  /* Start, Stop, Num points per decade, gain size, and gain array */
//    demo.AD5940_Main(100000, 0.1, 6, gainSize, test);

  /* Testing ADC Voltage Readings */

//  demo.AD5940_TDDNoise(0.0, 0.0); // Using default 1.11V reference
//  demo.AD5940_ADCMeasure();

    /* Noise Measurements*/
//    delay(2000);
//    demo.ADCNoiseTest();
//    demo.AD5940_HSTIARcal(HSTIARTIA_160K, 149700); 

    /* If you want to save noise data - optional but might contribute to noise */
//    demo.saveDataNoise("03-21-24", "5k-ohms");
}

void loop() {
  parseSerialCommand();

  // Physical button can also trigger a sweep
  if (digitalRead(BUTTON) == LOW && !measurementRequested) {
    delay(50);
    if (digitalRead(BUTTON) == LOW) {
      Serial.println("Button pressed; starting default sample EIS");
      demo.setParameters(
        MODE_EIS, 200000.0, 1.0, 5, 0.0, 0.0, rcalVal, 1, 1, rct_estimate, rs_estimate, 0, 0, 200.0);
      measurementRequested = true;
    }
  }

  // BLE trigger: web app wrote start=1 to the start characteristic
  if (demo.checkBLESweepRequest() && !measurementRequested) {
    Serial.println("[BLE] Sweep triggered via web app.");
    demo.readBLEParameters();
    demo.setParameters(
      MODE_EIS, demo.getStartFreq(), demo.getEndFreq(), demo.getNumPoints(),
      demo.getBiasVolt(), demo.getZeroVolt(), demo.getRcalVal(),
      demo.getExtGain(), demo.getDacGain(), demo.getRctEstimate(), demo.getRsEstimate(),
      demo.getNumCycles(), demo.getDelaySecs(), 200.0);
    measurementRequested = true;
  }

  // Auto-trigger: on first boot or when the interval has elapsed
  if (wearableMode && !measurementRequested) {
    unsigned long now = millis();
    if (firstBoot || (now - lastSweepMs >= sweepIntervalSec * 1000UL)) {
      firstBoot = false;
      Serial.println("[WEARABLE] Auto-triggering EIS sweep...");
      demo.setParameters(
        MODE_EIS, 200000.0, 1.0, 5, 0.0, 0.0, rcalVal, 1, 1, rct_estimate, rs_estimate, 0, 0, 200.0);
      measurementRequested = true;
    }
  }

  if (measurementRequested) {
    measurementRequested = false;
#if LEDPIN >= 0
    digitalWrite(LEDPIN, LOW);
#endif

    Serial.println("\n=== Starting Measurement ===");
    demo.print_settings();
    Serial.println("============================\n");

    MeasurementMode mode = demo.getMeasurementMode();

    switch (mode) {
      case MODE_EIS:
        demo.AD5940_TDD(test, gainSize);

        Serial.println("Running frequency sweep...");
        demo.runSweep();

        if (demo.wasAborted()) {
          Serial.println("\n=== Sweep ABORTED — partial data follows ===");
          demo.printDataCSV();
          Serial.println("Ready for next measurement.");
        } else {
          Serial.println("\nCalculating Rct and Rs...");
          demo.calculateResistors();

          Serial.println("\n=== Measurement Complete ===");
          demo.printDataCSV();

          demo.BLE_transmitResults();
          demo.saveDataEIS();
        }
        break;

      case MODE_CV:  demo.runCV();  break;
      case MODE_IT:  demo.runIT();  break;
      case MODE_CP:  demo.runCP();  break;
      case MODE_DPV: demo.runDPV(); break;
      case MODE_SWV: demo.runSWV(); break;
      case MODE_OCP: demo.runOCP(); break;
      default:
        Serial.println("ERROR: Unknown measurement mode!");
        break;
    }

    lastSweepMs = millis();
    delay(500);
    blinkLED(0, 1);
    Serial.println("\nReady for next measurement.\n");

    // In wearable mode, wait until the next sweep interval.
    // Uses a polling loop instead of light sleep so the USB-Serial/JTAG
    // interface stays alive for development. The RTOS idle task still
    // reduces power when nothing is happening.
    if (wearableMode && sweepIntervalSec >= 10) {
      Serial.print("[WEARABLE] Next sweep in ");
      Serial.print(sweepIntervalSec);
      Serial.println(" s (send any command or press button to interact)...");
      Serial.flush();
    }
  }

  delay(10);
}

void blinkLED(int cycles, bool state) {
#if LEDPIN < 0
  (void)cycles;
  (void)state;
  return;
#else
  if (state) {
    digitalWrite(LEDPIN, HIGH);
    delay(10);
  } else {
    for (int i = 0; i < cycles; i++) {
      digitalWrite(LEDPIN, HIGH);
      delay(1000);
      digitalWrite(LEDPIN, LOW);
      delay(1000);
    }
  }
#endif
}
