Shivasa042/Potentiostat-Wearable-Sensor-Berkeley-MEng-Capstone/(commit log)

2026-03-20 Complete HELPStat potentiostat firmware with EIS measurement system
    ESP32-S3 + AD5940 wearable impedance spectroscopy platform supporting USB serial, BLE, SD card, and physical button operation modes. Includes Python data capture scripts, comprehensive documentation, and the original HELPStat Android companion app for reference.
    Made-with: Cursor
    [HELPStat_V2.brd, HELPStat_V2.sch, PCBWayQuotedBOM_5Sets_2024-01-11.xls]
2026-03-24 Update EIS range to 1Hz-200kHz and apply AD5940 datasheet corrections
    - Set default sweep range to 1 Hz - 200 kHz per paper specification
    - Fix ADC rate double-assignment bug (LP mode now correctly uses 800 kHz)
    - Add ADCBUFCON register switching for HP/LP mode transitions
    - Use ADCPGA_1P5 (production-calibrated) and SINC3 OSR=4 as defaults
    - Fix zero-delay bug in DFT measurement timing calculations
    - Replace flat 1s settling delay with frequency-proportional timing
    - Add dynamic HSTIA CTIA capacitor selection based on RTIA and frequency
    - Update gain array to cover up to 200 kHz
    - Clean up build artifacts and add .gitignore
    - Update README with new frequency range and improvement details
    M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
    [main.cpp]
2026-03-26 Wearable 2-electrode mode, plotting script, docs, USB-safe idle
    - Switch HELPStat switch matrix to 2-electrode (SWP_CE0) across measurement paths
    - main.cpp: wearable auto-sweep timer, WEARABLE/INTERVAL serial commands, remove light sleep on USB-Serial/JTAG (polling wait instead)
    - Add plot_eis_from_file.py for Nyquist/Bode from CSV or Excel
    - README: analysis section, script table, repo layout, wearable timing wording
    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
2026-03-30 Reorganize Python tools under testing/; move sample plots; update README
    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
2026-03-31 Fix eis_sweep CSV header match; add scenario1_serial_sample.py for USB capture
    - Recognize firmware line Frequency(Hz) as well as Freq(Hz)
    - Add scenario1_serial_sample.py: Scenario-1 serial sweep with EIS CSV block capture
    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
    [eis_sweep.py, scenario1_serial_sample.py]
2026-03-31 README: add Troubleshooting (Scenario 3 timing, CSV/scope, QC/filtering)
    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
2026-03-31 Set default RCAL to 100 Ohm (on-board nominal); sync docs and scripts
    RCAL value in firmware and MEASURE commands must match the physical
    calibration resistor; brown-black-brown is 100 Ohm, not 1 kOhm.
    Updated main defaults, HELP examples, testing scripts, README, web
    companion placeholder, and MEASUREMENT_MODES examples.
    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
2026-03-31 scenario1_serial_sample: send WEARABLE:OFF before MEASURE to avoid queued auto-sweeps when idle
    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
    [scenario1_serial_sample.py]
2026-03-31 Faster lab sweeps: default WEARABLE off, short scenario1 band, serial sync
    - Default wearableMode false so USB/bench is not blocked by a full auto-sweep; Scenario 3 uses WEARABLE:ON.
    - scenario1_serial_sample: 10 kHz–1 kHz, 2 DFT points, 150 mV; wait for idle before MEASURE; quiet long serial drains.
    - README: document wearable default and field enablement.
    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
    [main.cpp, scenario1_serial_sample.py]
2026-03-31 Add testing/board_status_wearable.py for STATUS and WEARABLE:ON
    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
2026-03-31 board_status_wearable: wait_ready only on Ready line
    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
2026-03-31 README: document quick USB scripts, wearable defaults, RCAL, COM troubleshooting
    - Add Quick USB lab scripts section (scenario1_serial_sample, board_status_wearable).
    - List new scripts in repo tree and Python scripts table.
    - Note py -m platformio upload and COM port busy fixes.
    - Expand troubleshooting for PermissionError and sweep blocking serial.
    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
2026-03-31 Fix MEASURE:SAMPLE order: handle before generic MEASURE branch (was unreachable)
    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
    [main.cpp]
2026-03-31 README: EIS accuracy section (RCAL, RTIA vs RCAL, DFT, SD, LMA, temperature)
    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
2026-03-31 Align EIS engine with WatchScript: default 1k RCAL, averaging, sweep fix
    - Default rcalVal/_rcalVal 1000 ohm; document 1k RCAL vs legacy 100 ohm boards
    - runSweep always uses AD5940_DFTMeasureWithAveraging (default _numAverages=3)
    - Fix WithAveraging missing logSweep/configureFrequency (prevent sweep hang)
    - AD5940_DFTMeasure retries validation; stores NaN if all attempts fail
    - README and NEW_FEATURES: WatchScript notes, SD timestamps, testing rcal 1000
    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
    [eis_sweep.py, main.cpp, replug_and_sweep.py, scenario1_serial_sample.py, send_eis_sample.py]
2026-04-08 Fix DFT poll hang with timeout; CS=38 default; PlatformIO and docs
    - pollDFT returns bool with ~30s timeout; callers handle failure
    - constants.h: CS=38 for current bench wiring; README known issues
    - custom_s3 board JSON, platformio lab-board-cs38 env
    - scenario1_serial_sample waits for System ready
    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
    [scenario1_serial_sample.py]
2026-04-08 Add KiCad EIS PCB under boards/New_EIS_PCB_Akshay
    - eis_pcb project (schematic + 4-layer PCB), fp/sym tables, fabrication-toolkit options
    - README: document new boards section
    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
    [eis_pcb.kicad_pcb, eis_pcb.kicad_sch]
2026-04-08 Add New_EIS_PCB_Akshay firmware support: SPI DFT polling, display UI, board-specific pins
    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
2026-04-08 Rewrite README: concise overview, both board variants, errors/fixes, EIS explanation
    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
2026-04-10 Add display backlight, sweep timings, measurement data, update README
    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
    [eis_200hz_single.csv, eis_sweep_10hz_200khz.csv, eis_sweep_10hz_single.csv, eis_sweep_1hz_200khz_wearable_range.csv, eis_sweep_200khz_single.csv, eis_sweep_result.csv, scenario1_eis_sample.csv, scenario1_eis_sample_single.csv]
2026-04-15 Optimize EIS sweep speed: full 1 Hz-200 kHz in ~108 s (was ~5-6 min)
    Reduce settling delay from 4 to 2 AC periods, cut fixed gain-switch delays from 200 ms to 50 ms, drop per-point averaging from 3 to 1, and lower default points/decade from 10 to 5. All 27 frequency points remain valid with a 10 kOhm bench load. These parameters are tunable for noisier electrochemical loads.
    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
    [main.cpp]
2026-04-15 Rename web app to PHEW, update defaults to match firmware
    Rename HELPStat to PHEW across index.html, manifest, app.js, ble.js. Update default sweep parameters: Rct 127k, Rs 150, Rcal 10k, 5 pts/decade, start 200kHz, end 1Hz. Update favicon and PWA icon letter H to P.
    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
2026-04-15 Update README with comprehensive PHEW web app documentation
    Add detailed description of the PHEW companion app: what each tab does, data flow diagram, default parameters table, step-by-step access instructions, browser compatibility matrix, and PWA install notes.
    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
2026-04-15 Add live sweep progress indicator to PHEW web app
    Shows a gradient progress bar, point count (e.g. 5/27), current frequency, and elapsed timer. Updates in real time as each BLE frequency notification arrives. Displays completion summary when sweep finishes.
    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
2026-04-15 Add sweep abort: STOP serial command, BLE stop (start=2), and web app Stop button
    Firmware: volatile _abortSweep flag checked in both runSweep() overloads. Serial STOP command and BLE write of start=2 both trigger abort. Aborted sweeps shut down the AFE cleanly and print partial data without attempting Rct/Rs fit or BLE transmit. Web app: red Stop button replaces Run sweep during a sweep, sends start=2 via BLE. Progress bar turns red on abort with point count summary.
    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
    [main.cpp]
2026-04-15 Update README with sweep abort documentation
    Add STOP to command table, new Stopping a sweep section with all three abort methods, update PHEW instructions to mention Stop button and progress bar, add sweep abort to firmware features list.
    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
2026-04-15 Fix BLE sweep trigger: web app can now start sweeps over Bluetooth
    The BLE start characteristic write was never wired into main loop(). Added StartCharCallbacks::onWrite handler for start=1 that sets _bleSweepRequested flag, readBLEParameters() to transfer BLE characteristic values to member vars, getter methods for all sweep parameters, and a check in loop() that triggers measurementRequested when BLE start=1 is received.
    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
    [main.cpp]
2026-04-15 Fix BLE sweep defaults: always send all parameters to firmware
    When form fields were left blank (placeholder only), startFreq, endFreq, numPoints, rcalVal, and other params were never sent over BLE, causing the firmware to use stale/uninitialized values. Now all fields fall back to firmware MEASURE:SAMPLE defaults (200kHz, 1Hz, 5 pts/dec, 10k rcal, etc.).
    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
2026-04-15 Add CSV export for individual sweeps
    Export CSV button in History tab downloads the selected sweep as Frequency,Real,Imaginary,Magnitude,Phase CSV with Rct/Rs appended, matching the firmware serial output format. Filename includes date and sweep number.
    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
2026-04-15 Document PHEW CSV export in README
    Describe Export CSV in History tab, data flow, backup note, and step-by-step export instructions including filename and column layout.
    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
2026-04-15 docs: expand PHEW web app usage and Windows PowerShell notes
    - Document PowerShell 5.x without &&, semicolon/two-line alternatives, py launcher
    - Warn against multiple http.server instances on the same port
    - Clarify hardware/BLE prerequisites, Live/History workflow, export formats
    - Add PHEW troubleshooting table for common browser and connection issues
    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
